XavierGoff/Lecture-Pulse/Images/README.md

# Images

- `hero.jpg` — the finished pad in the wild
- `breadboard-v1.jpg`, `breadboard-v2.jpg` — prototype electronics builds
- `festival/` — Great Exhibition Road Festival showcase (13 photos)
