XavierGoff/Lecture-Pulse/Electronics/tinkercad-v1.png

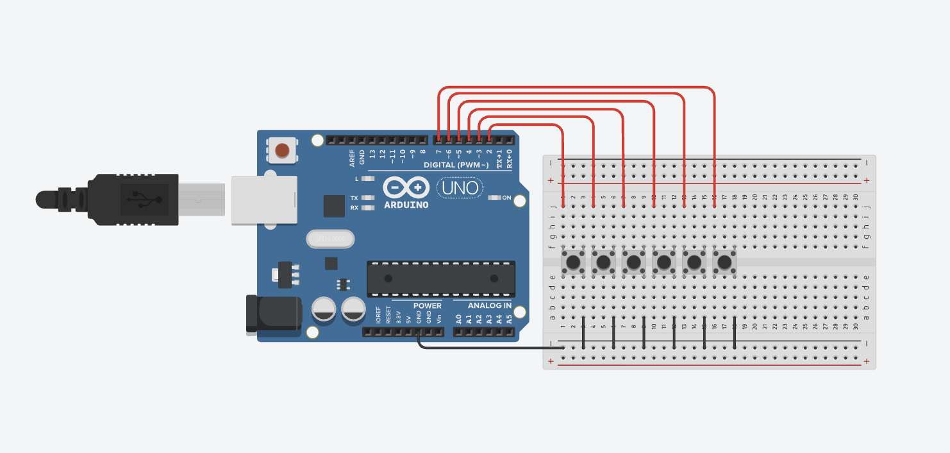
Electronics/tinkercad-v1.png
