XavierGoff/Lecture-Pulse/Electronics/tinkercad-v2.png

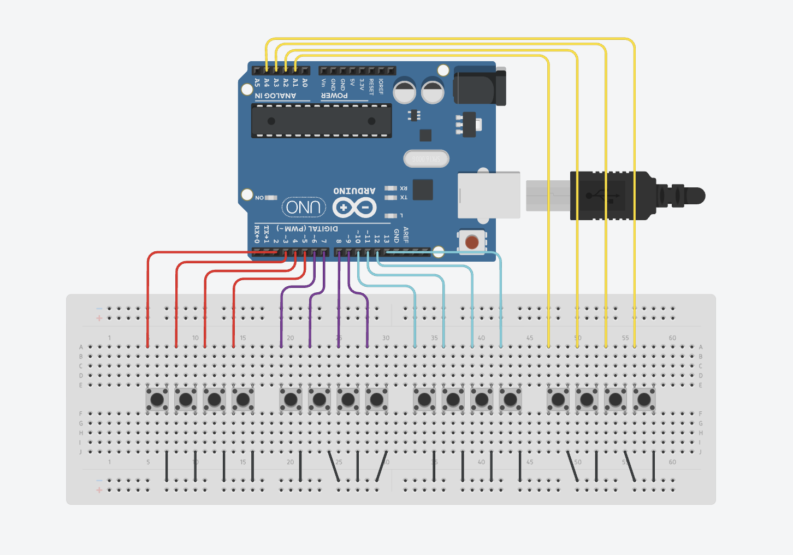
Electronics/tinkercad-v2.png
