XavierGoff/Lecture-Pulse/Images/breadboard-v1.jpg

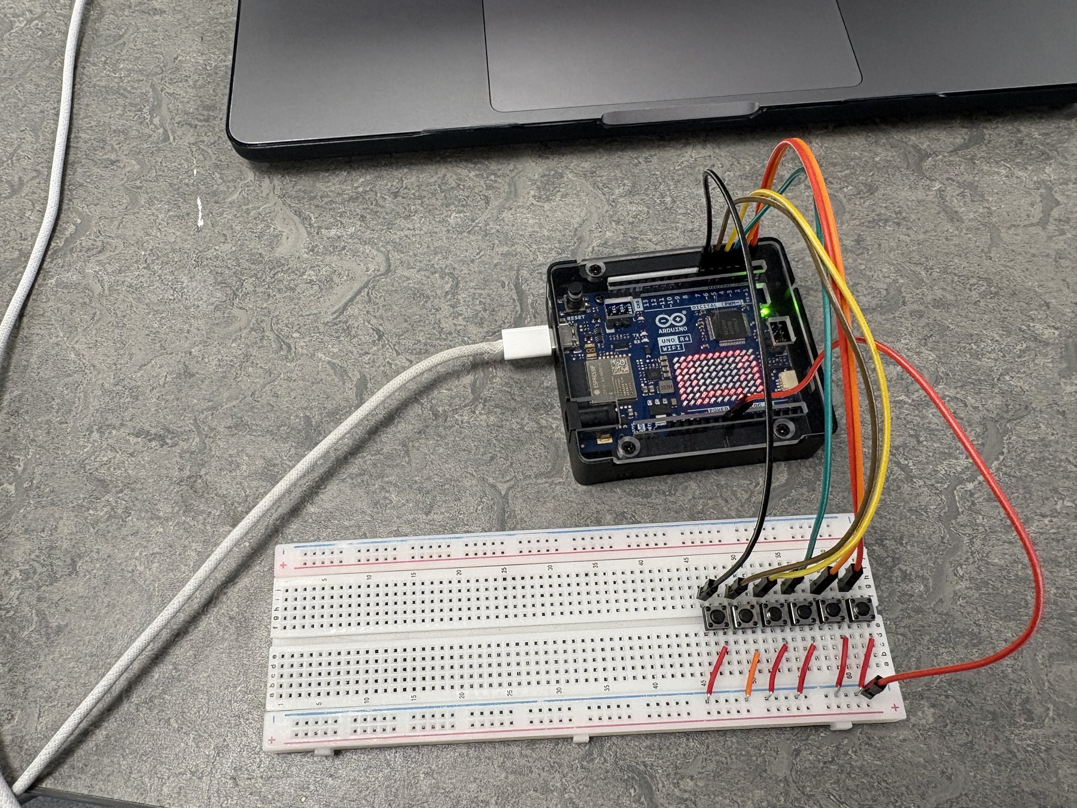
Images/breadboard-v1.jpg
