XavierGoff/Lecture-Pulse/Images/breadboard-v2.jpg

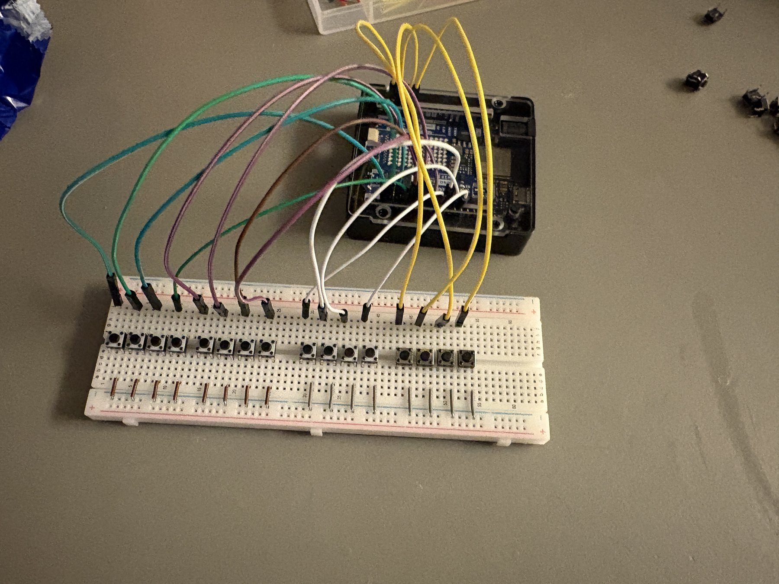
Images/breadboard-v2.jpg
