XavierGoff/Lecture-Pulse/Images/festival/dsc05338.jpg

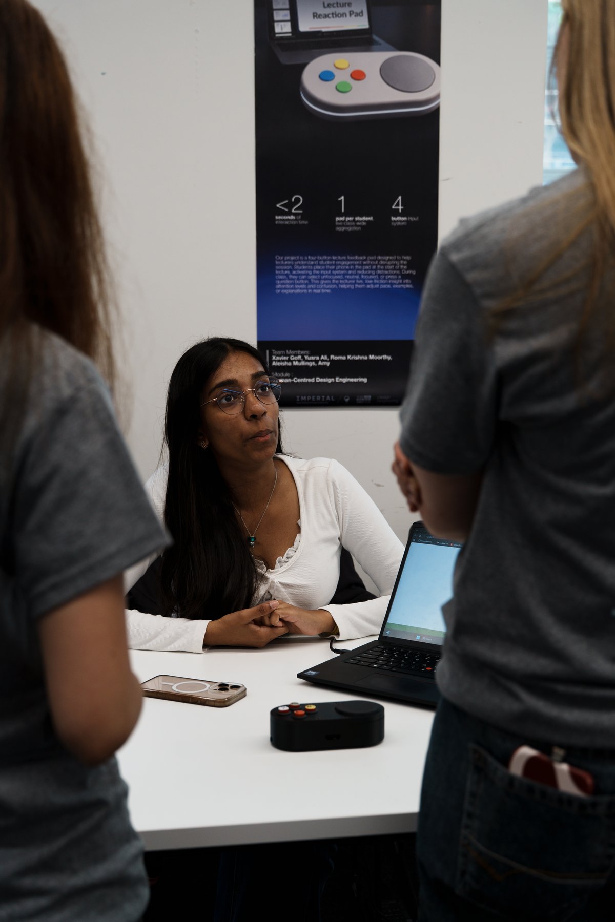
Images/festival/dsc05338.jpg
