XavierGoff/Lecture-Pulse/Images/festival/dsc05354.jpg

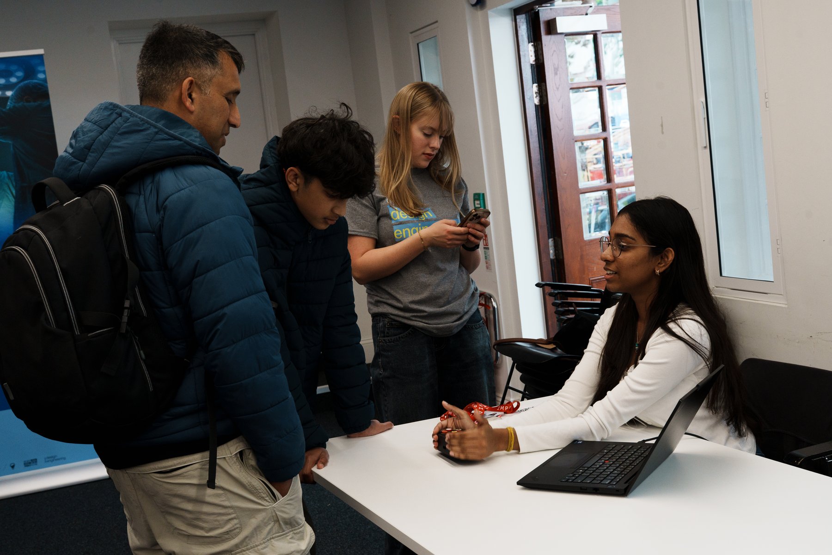
Images/festival/dsc05354.jpg
