XavierGoff/Lecture-Pulse/Images/festival/dsc05362.jpg

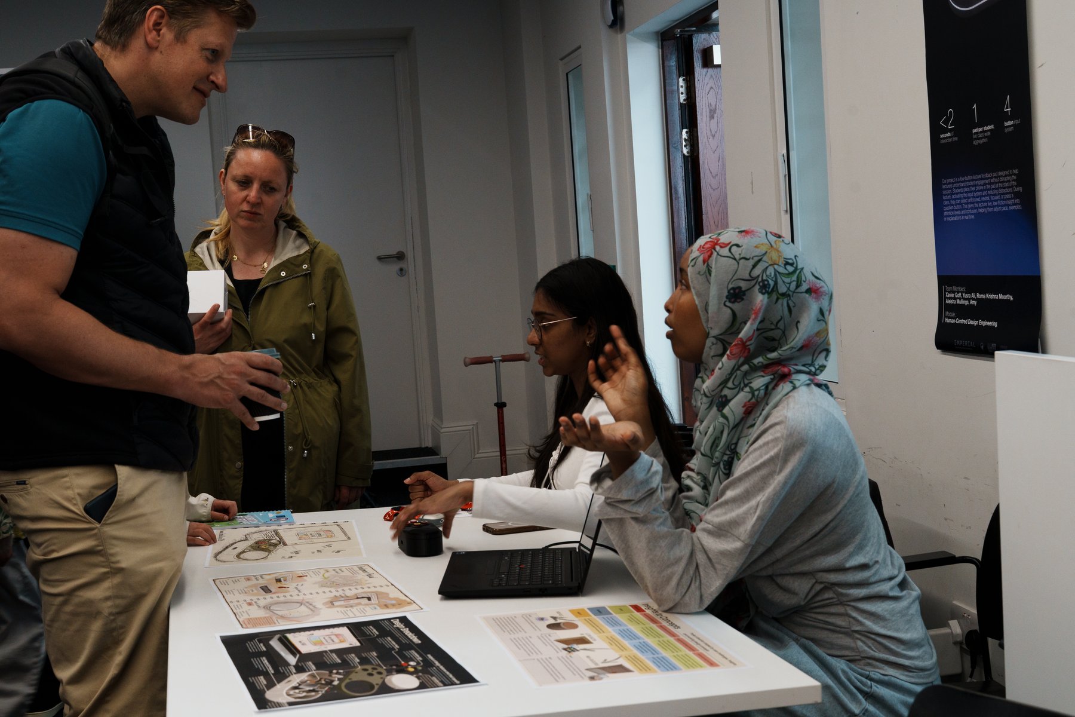
Images/festival/dsc05362.jpg
