XavierGoff/Lecture-Pulse/Images/festival/dsc05363.jpg

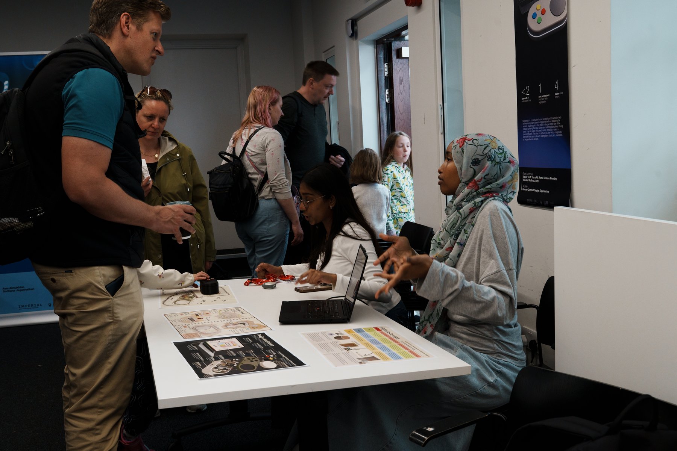
Images/festival/dsc05363.jpg
