XavierGoff/Lecture-Pulse/Images/festival/dsc05415.jpg

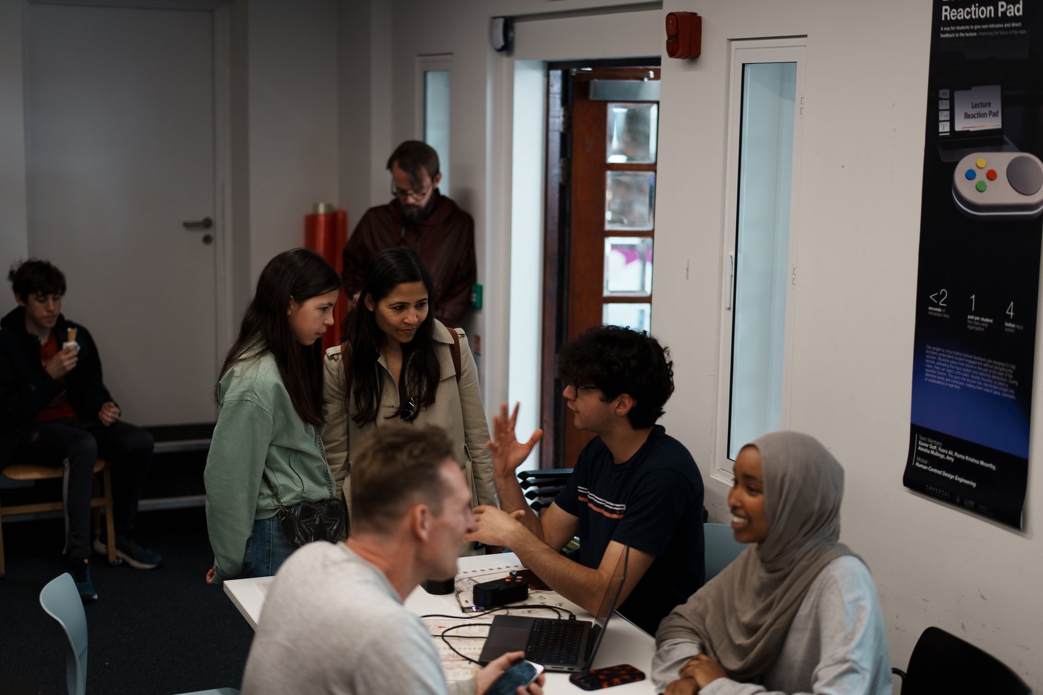
Images/festival/dsc05415.jpg
