XavierGoff/Lecture-Pulse/Images/festival/dsc05416.jpg

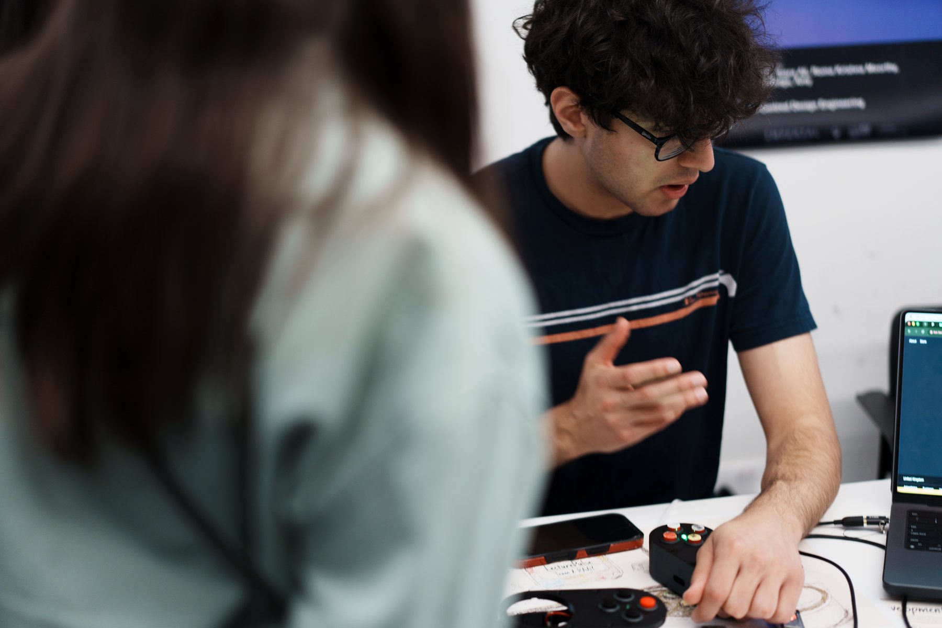
Images/festival/dsc05416.jpg
