XavierGoff/Lecture-Pulse/Images/festival/dsc05417.jpg

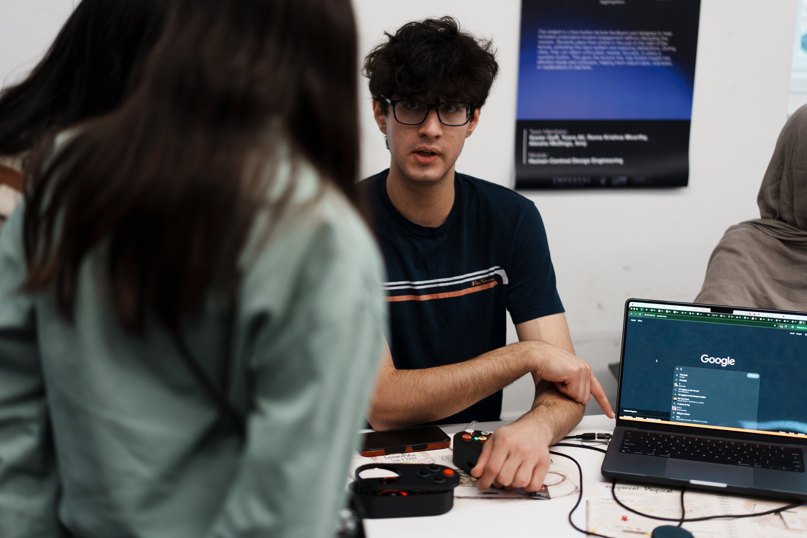
Images/festival/dsc05417.jpg
