XavierGoff/Lecture-Pulse/Images/festival/dsc05418.jpg

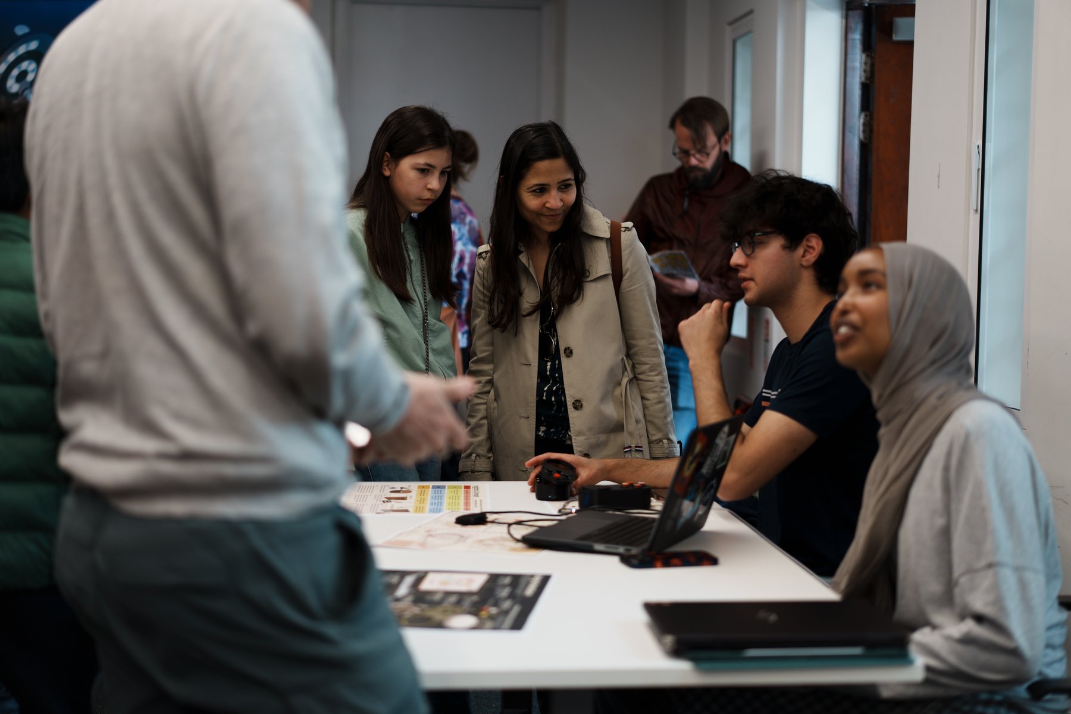
Images/festival/dsc05418.jpg
