XavierGoff/Lecture-Pulse/Images/festival/dsc05425.jpg

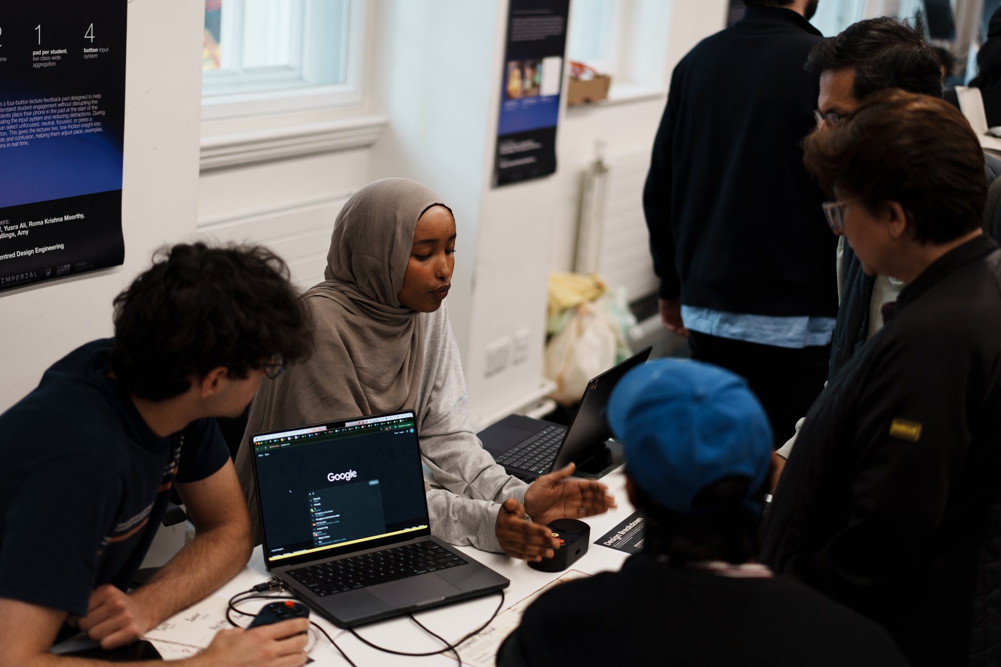
Images/festival/dsc05425.jpg
