XavierGoff/Lecture-Pulse/Images/festival/dsc05426.jpg

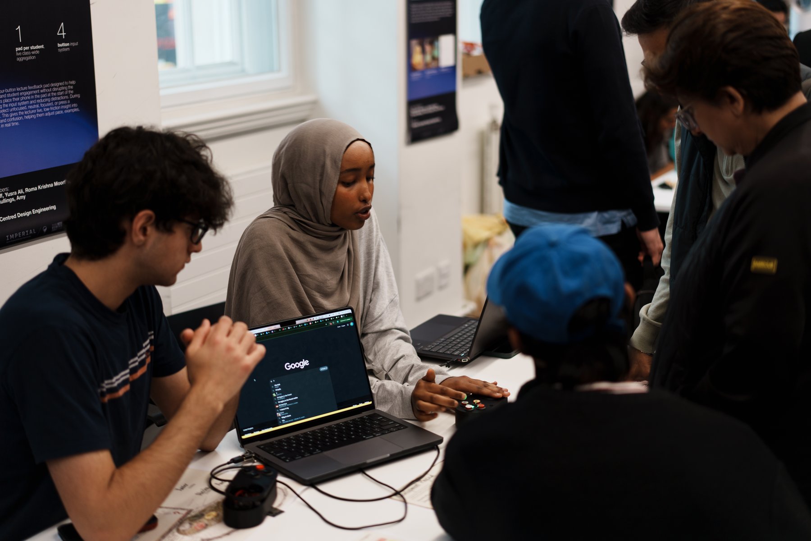
Images/festival/dsc05426.jpg
