XavierGoff/Lecture-Pulse/Images/festival/dsc05428.jpg

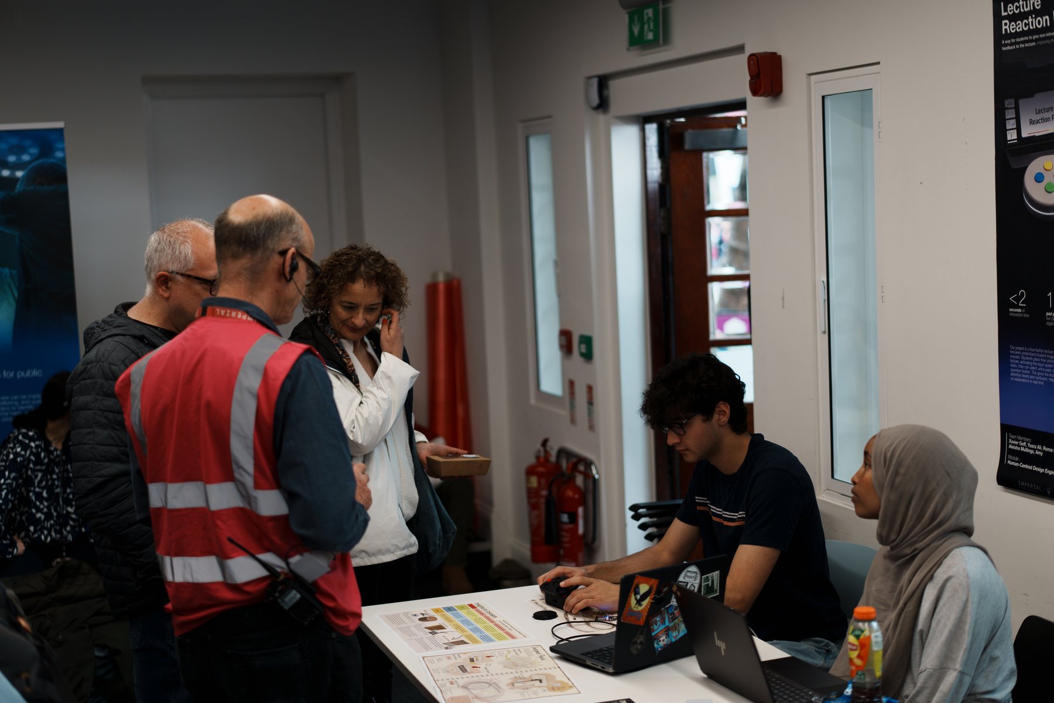
Images/festival/dsc05428.jpg
