XavierGoff/Lecture-Pulse/Images/festival/dsc05429.jpg

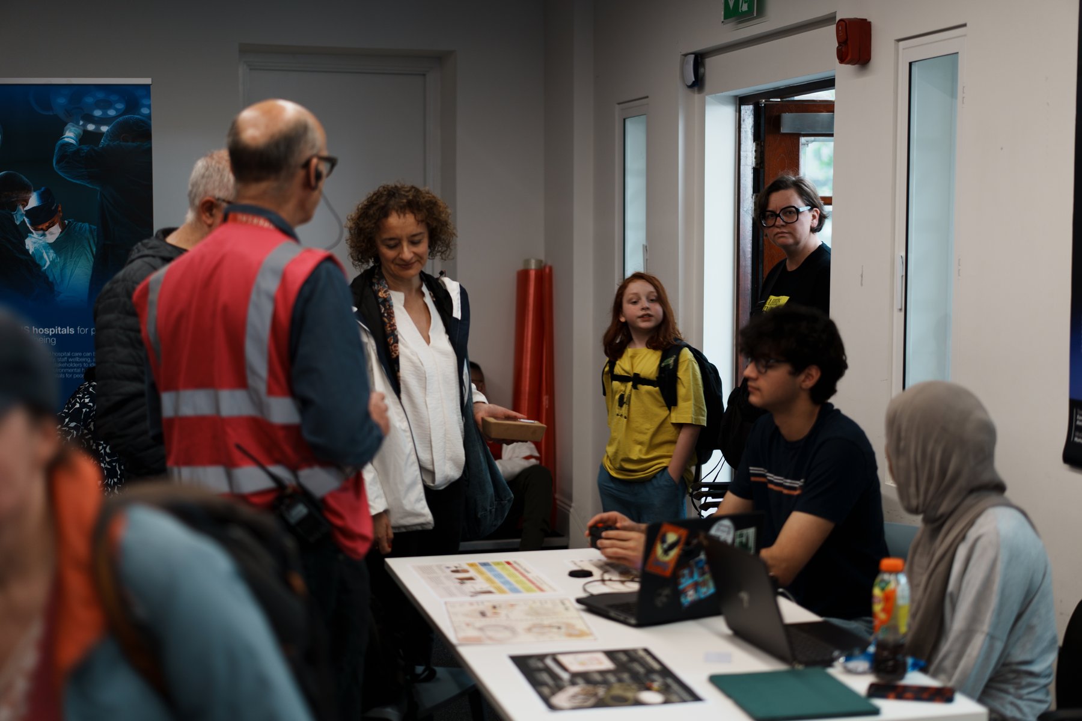
Images/festival/dsc05429.jpg
