XavierGoff/Lecture-Pulse/Images/festival/send-to-lecture-pad.jpg

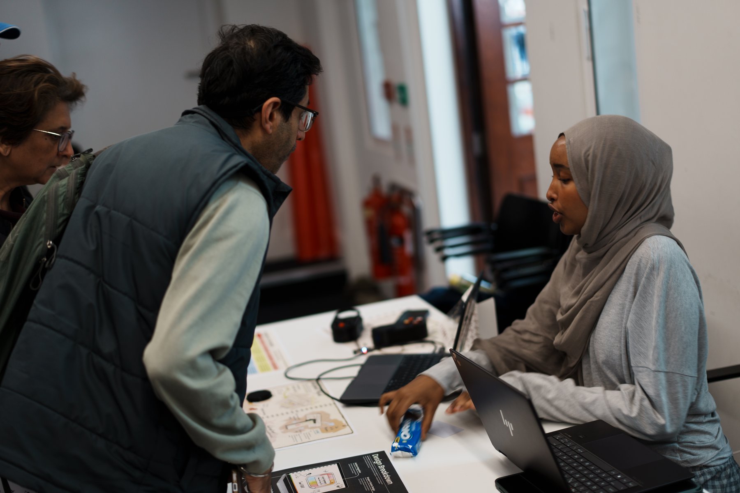
Images/festival/send-to-lecture-pad.jpg
