XavierGoff/Lecture-Pulse/CAD/Full Assembly.step

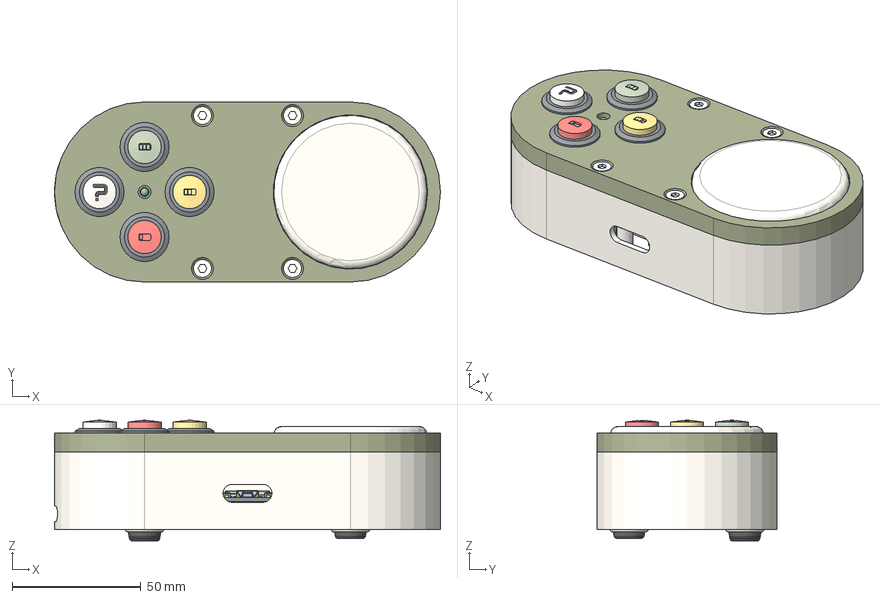
[picture p20: CAD file, 2026-07-09]
CAD/Full Assembly.step
150.0 x 70.0 x 47.0 mm
silk - top x 37
silk - bottom x 105
Surface 1 x 4
push button x 7
chip (1) x 9
chip x 22
USB-C port x 24
bits (9)
pads x 26
SC-107-lead1 x 3
board
bits
bits (1) x 2
Led 3mm green v1
led (6) x 4
SC-107-lead1 (1) x 3
bits (8)
SC-107-body
SC-107-leadN (1) x 3
SC-107-body (1)
SC-107-leadN x 3
bits (2) x 2
led (5) x 4
jst ph 2-pin x 6
bits (6)
resistor
bits (10)
bits (7) x 2
bits (5)
