XavierGoff/Lecture-Pulse/CAD/PhonePlacementPad.stl

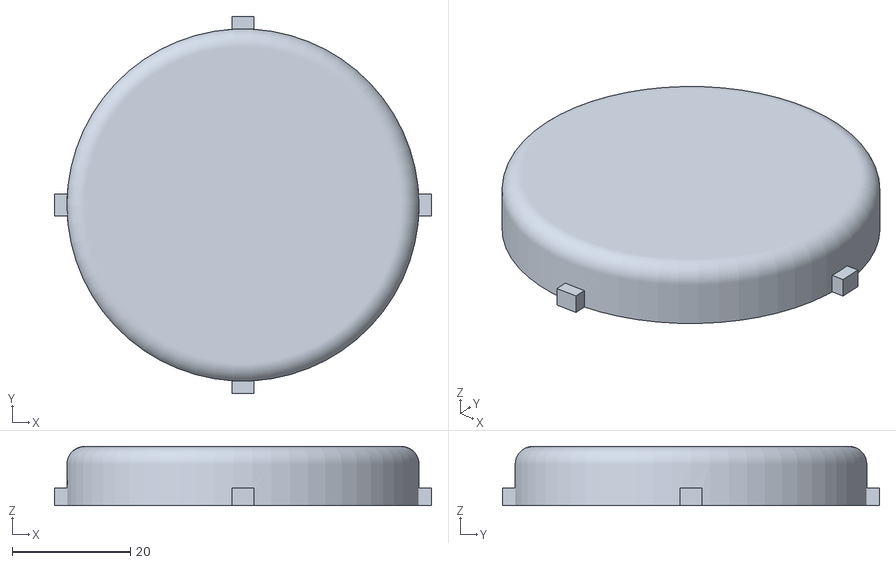
[picture p21: CAD file, 2026-07-09]
CAD/PhonePlacementPad.stl
63.7 x 63.7 x 10.0
