XavierGoff/Lecture-Pulse/CAD/Casing.stl

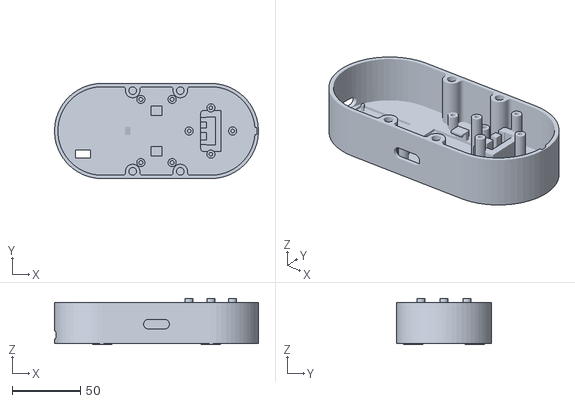
[picture p22: CAD file, 2026-07-09]
CAD/Casing.stl
150.0 x 70.0 x 34.0
