XavierGoff/Lecture-Pulse/CAD/Top Cover.stl

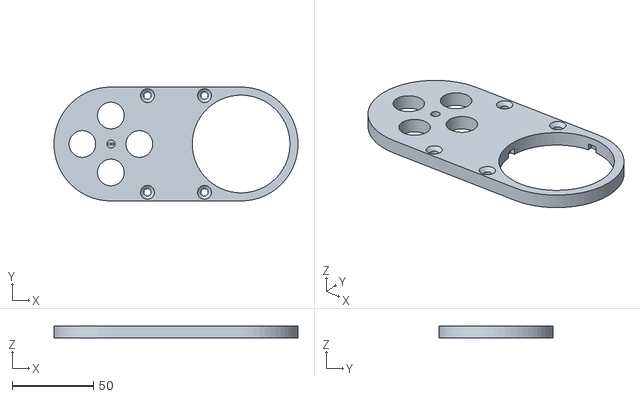
[picture p23: CAD file, 2026-07-09]
CAD/Top Cover.stl
149.9 x 70.0 x 7.50
