XavierGoff/Lecture-Pulse/Code/bridge/serial_bridge.py

import asyncio
import serial
import serial.tools.list_ports
import websockets
import json
import sys

SERIAL_PORT = None
BAUD_RATE   = 9600
WS_HOST     = "localhost"
WS_PORT     = 8765

connected_clients = set()
state = {"score": 0.0, "question": False}

def find_esp32():
    for port in serial.tools.list_ports.comports():
        desc = (port.description or "").lower()
        mfr  = (port.manufacturer or "").lower()
        print(f"Found port: {port.device} | {port.description} | {port.manufacturer}")
        if any(k in desc or k in mfr for k in ["cp210", "ch340", "ftdi", "esp", "uart", "usb"]):
            print(f"[Bridge] Using {port.device}")
            return port.device
    return None

async def ws_handler(websocket):
    connected_clients.add(websocket)
    print(f"[Bridge] Browser connected ({len(connected_clients)} total)")
    await websocket.send(json.dumps(state))
    try:
        await websocket.wait_closed()
    finally:
        connected_clients.discard(websocket)

async def broadcast():
    if connected_clients:
        msg = json.dumps(state)
        await asyncio.gather(*(ws.send(msg) for ws in connected_clients), return_exceptions=True)

async def read_serial(port):
    print(f"[Bridge] Opening {port} at {BAUD_RATE} baud...")
    try:
        ser = serial.Serial(port, BAUD_RATE, timeout=1)
    except serial.SerialException as e:
        print(f"[Bridge] ERROR: {e}"); sys.exit(1)
    print("[Bridge] Ready.")
    loop = asyncio.get_event_loop()
    while True:
        line = await loop.run_in_executor(None, ser.readline)
        if not line: continue
        text = line.decode("utf-8", errors="ignore").strip()
        if not text: continue
        print(f"[Serial] {text}")
        changed = False
        if text.startswith("SCORE:"):
            try:
                state["score"] = round(float(text.split(":")[1]), 2)
                changed = True
            except ValueError: pass
        elif text.startswith("QUESTION:"):
            try:
                state["question"] = bool(int(text.split(":")[1]))
                changed = True
            except ValueError: pass
        if changed:
            await broadcast()

async def main():
    port = SERIAL_PORT or find_esp32()
    if not port:
        print("[Bridge] No device found."); sys.exit(1)
    print(f"[Bridge] WS server on ws://{WS_HOST}:{WS_PORT}")
    async with websockets.serve(ws_handler, WS_HOST, WS_PORT):
        await read_serial(port)

if __name__ == "__main__":
    try: asyncio.run(main())
    except KeyboardInterrupt: print("\n[Bridge] Stopped.")
